Jana-Marie/OtterStepMacro/README.md

# OtterStepMacro

### Issues

 - [ ] Tab spacing needs to be 5.08mm/2" instead of 5mm
 - [ ] Move the Terminal connectors further to the board edge, maybe 0.2mm
 - [x] The two 100nF 0402 caps should be 0603
 - [x] Pullup on TRIG# OtterStepMacro
