Jana-Marie/OtterStepMacro/MacroStep.kicad_pcb

## KiCad design MacroStep.kicad_pcb (2025-08-17)

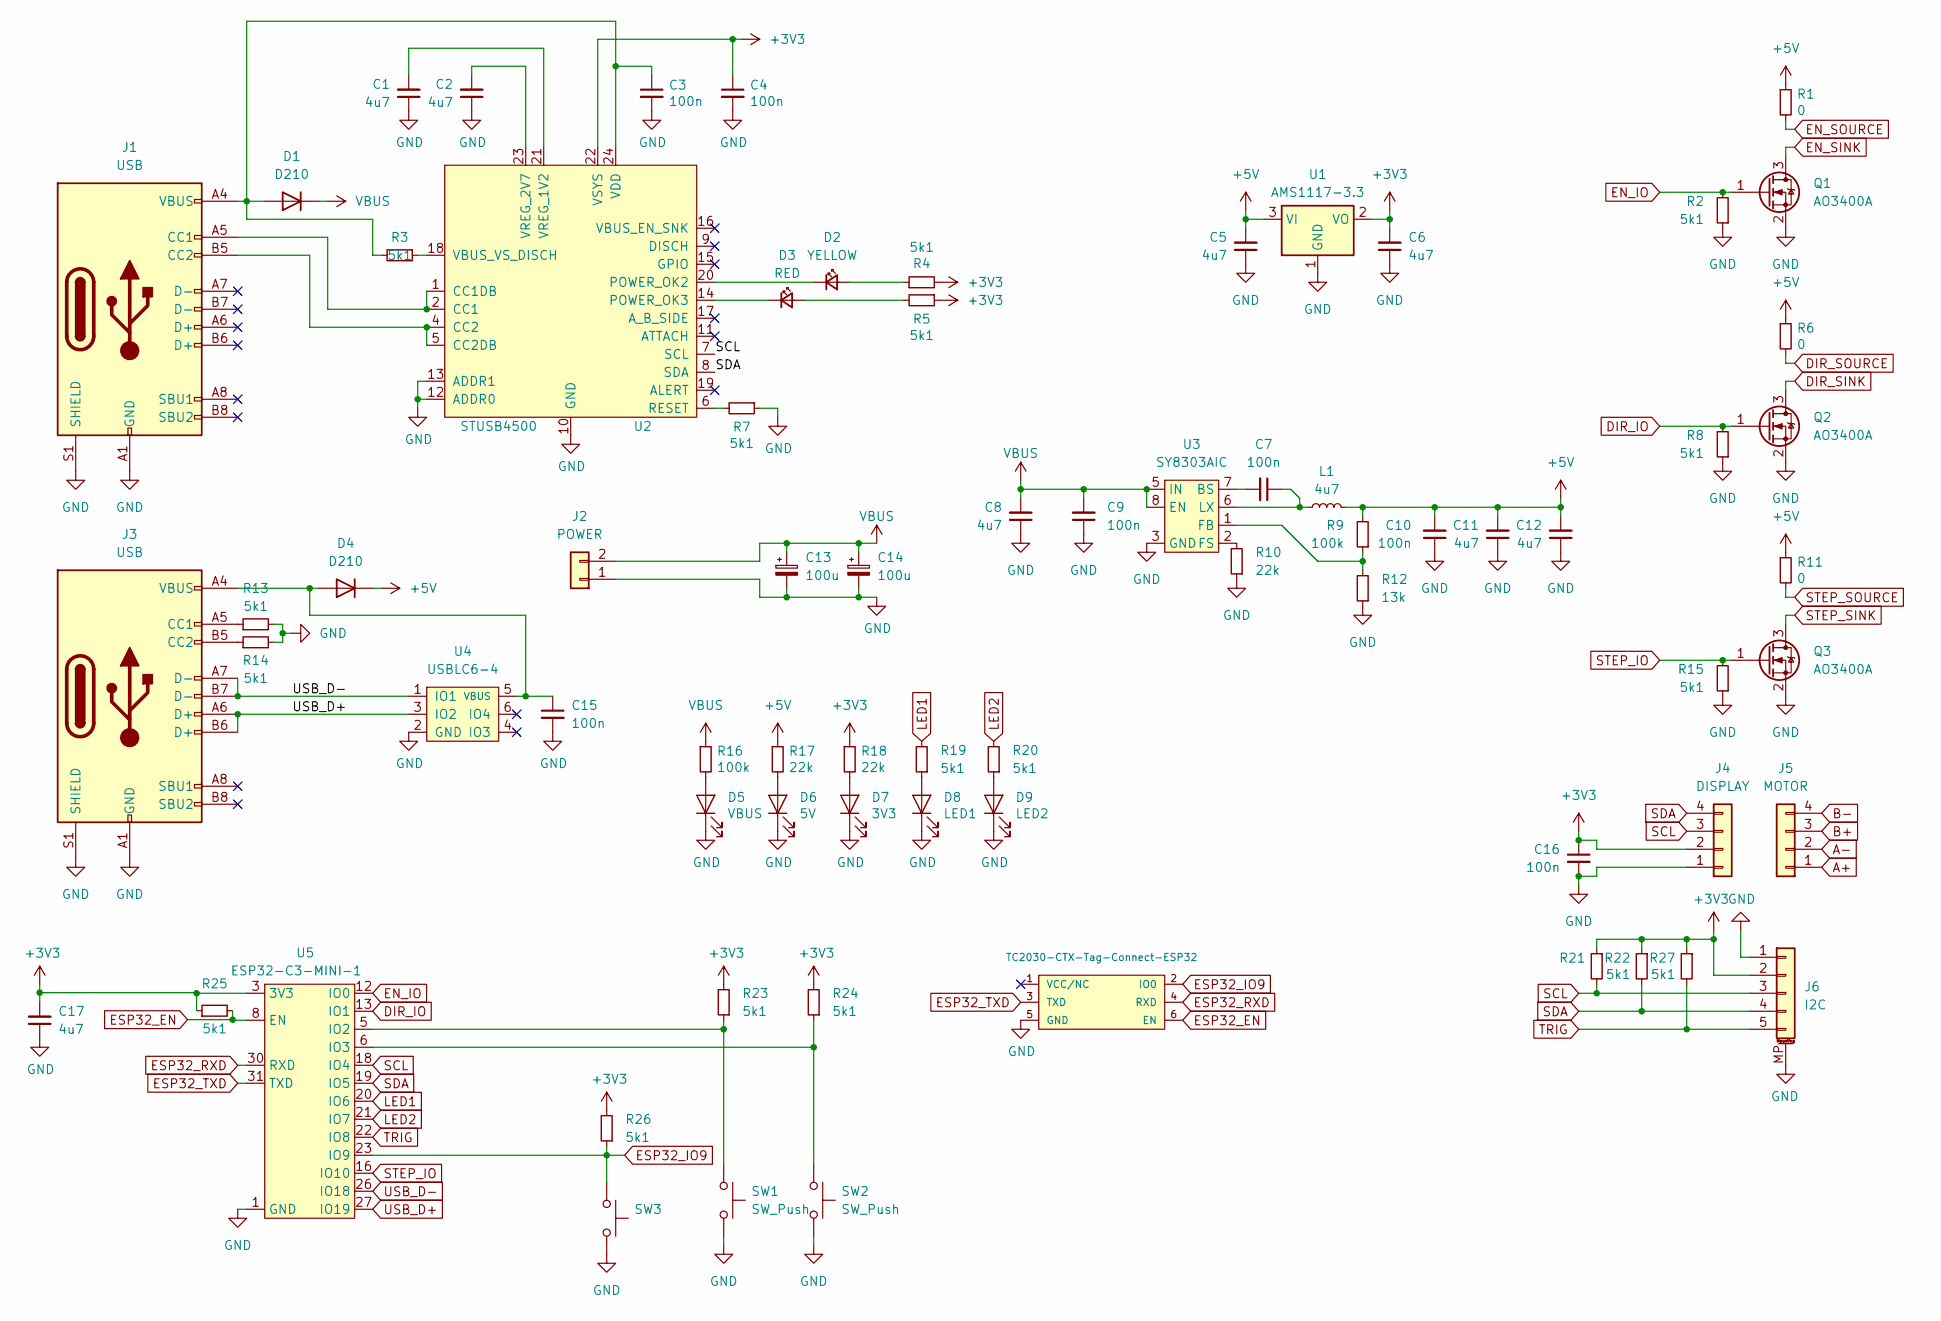
[picture p1: schematic MacroStep.kicad_sch]

Parts:
C1, C2, C5, C6, C8, C11, C12, C17: 4u7; C_0805
C3, C4, C7, C9, C10, C15, C16: 100n; C_0603
C13, C14: 100u; CP_Radial_D10.0mm_P5.00mm
D1, D4: D210; D_SMA
D2: YELLOW; LED_0603_1608Metric
D3: RED; LED_0603_1608Metric
D5: VBUS; LED_0603_1608Metric
D6: 5V; LED_0603_1608Metric
D7: 3V3; LED_0603_1608Metric
D8: LED1; LED_0603_1608Metric
D9: LED2; LED_0603_1608Metric
J1, J3: USB; USB-C 16Pin
J2: POWER; PhoenixContact_MC_1,5_2-G-3.5_1x02_P3.50mm_Horizontal
J4: DISPLAY; PinSocket_1x04_P2.54mm_Vertical_center
J5: MOTOR; PhoenixContact_MC_1,5_4-G-3.5_1x04_P3.50mm_Horizontal
J6: I2C; Molex_PicoBlade_53261-0571_1x05-1MP_P1.25mm_Horizontal
L1: 4u7; L_Taiyo-Yuden_MD-4040
P1: TC2030-CTX-Tag-Connect-ESP32; TC2030
Q1, Q2, Q3: AO3400A; SOT-23
R1, R6, R11: 0; R_0603
R2, R3, R4, R5, R7, R8, R13, R14, R15, R19, R20, R21, R22, R23, R24, R25, R26, R27: 5k1; R_0402
R9, R16: 100k; R_0402
R10, R17, R18: 22k; R_0402
R12: 13k; R_0402
SW1, SW2, SW3: SW_Push; SW_SPST_EVQP7C
U1: AMS1117-3.3; SOT-223-3_TabPin2
U2: STUSB4500; QFN-24-1EP_4x4mm_P0.5mm_EP2.7x2.7mm
U3: SY8303AIC; TSOT-23-8
U4: USBLC6-4; SOT-23-6
U5: ESP32-C3-MINI-1

Connections:
+3V3: C4.1, C6.2, C16.1, C17.2, J4.2, J6.2, R4.2, R5.1, R18.1, R21.1, R22.1, R23.2, R24.2, R25.1, R26.2, R27.1, U1.2 (VO), U2.22 (VSYS), U5.3 (3V3)
+5V: C5.2, C10.2, C11.2, C12.2, D4.1 (K), L1.2, R1.1, R6.1, R9.2, R11.1, R17.1, U1.3 (VI)
A+: J5.1
A-: J5.2
B+: J5.3
B-: J5.4
DIR_IO: Q2.1 (G), R8.2, U5.13 (IO1)
DIR_SINK: Q2.3 (D)
DIR_SOURCE: R6.2
EN_IO: Q1.1 (G), R2.2, U5.12 (IO0)
EN_SINK: Q1.3 (D)
EN_SOURCE: R1.2
ESP32_EN: P1.6 (EN), R25.2, U5.8 (EN)
ESP32_IO9: P1.2 (IO0), R26.1, SW3.1, U5.23 (IO9)
ESP32_RXD: P1.4 (RXD), U5.30 (RXD)
ESP32_TXD: P1.3 (TXD), U5.31 (TXD)
GND: C1.1, C2.1, C3.2, C4.2, C5.1, C6.1, C8.1, C9.1, C10.1, C11.1, C12.1, C13.2, C14.2, C15.2, C16.2, C17.1, D5.1 (K), D6.1 (K), D7.1 (K), D8.1 (K), D9.1 (K), J1.A1 (GND), J1.A12 (GND), J1.B1 (GND), J1.B12 (GND), J1.S1 (SHIELD), J2.1, J3.A1 (GND), J3.A12 (GND), J3.B1 (GND), J3.B12 (GND), J3.S1 (SHIELD), J4.1, J6.1, J6.MP (MountPin), P1.5 (GND), Q1.2 (S), Q2.2 (S), Q3.2 (S), R2.1, R7.1, R8.1, R10.1, R12.1, R13.2, R14.2, R15.1, SW1.2, SW2.2, SW3.2, U1.1 (GND), U2.10 (GND), U2.12 (ADDR0), U2.13 (ADDR1), U2.25 (GND), U3.3 (GND), U3.4 (GND), U4.2 (GND), U5.1 (GND), U5.2 (GND), U5.11 (GND), U5.14 (GND), U5.36 (GND), U5.37 (GND), U5.38 (GND), U5.39 (GND), U5.40 (GND), U5.41 (GND), U5.42 (GND), U5.43 (GND), U5.44 (GND), U5.45 (GND), U5.46 (GND), U5.47 (GND), U5.48 (GND), U5.49 (GND), U5.50 (GND), U5.51 (GND), U5.52 (GND), U5.53 (GND)
LED1: R19.2, U5.20 (IO6)
LED2: R20.2, U5.21 (IO7)
unnamed: C3.1, D1.2 (A), J1.A4 (VBUS), J1.A9 (VBUS), J1.B4 (VBUS), J1.B9 (VBUS), R3.2, U2.24 (VDD)
unnamed: D2.2 (A), R4.1
unnamed: D2.1 (K), U2.20 (POWER_OK2)
unnamed: D3.2 (A), R5.2
unnamed: D3.1 (K), U2.14 (POWER_OK3)
unnamed: C15.1, D4.2 (A), J3.A4 (VBUS), J3.A9 (VBUS), J3.B4 (VBUS), J3.B9 (VBUS), U4.5 (VBUS)
unnamed: D5.2 (A), R16.2
unnamed: D6.2 (A), R17.2
unnamed: D7.2 (A), R18.2
unnamed: D8.2 (A), R19.1
unnamed: D9.2 (A), R20.1
unnamed: J1.A5 (CC1), U2.1 (CC1DB), U2.2 (CC1)
unnamed: J1.B5 (CC2), U2.4 (CC2), U2.5 (CC2DB)
unnamed: J3.A5 (CC1), R13.1
unnamed: J3.B5 (CC2), R14.1
unnamed: R7.2, U2.6 (RESET)
unnamed: R3.1, U2.18 (VBUS_VS_DISCH)
unnamed: C1.2, U2.21 (VREG_1V2)
unnamed: C2.2, U2.23 (VREG_2V7)
unnamed: C7.2, U3.7 (BS)
unnamed: R9.1, R12.2, U3.1 (FB)
unnamed: R10.2, U3.2 (FS)
unnamed: C7.1, L1.1, U3.6 (LX)
unnamed: R23.1, SW1.1, U5.5 (IO2)
unnamed: R24.1, SW2.1, U5.6 (IO3)
SCL: J4.3, J6.3, R21.2, U2.7 (SCL), U5.18 (IO4)
SDA: J4.4, J6.4, R22.2, U2.8 (SDA), U5.19 (IO5)
STEP_IO: Q3.1 (G), R15.2, U5.16 (IO10)
STEP_SINK: Q3.3 (D)
STEP_SOURCE: R11.2
TRIG: J6.5, R27.2, U5.22 (IO8)
USB_D+: J3.A6 (D+), J3.B6 (D+), U4.3 (IO2), U5.27 (IO19)
USB_D-: J3.A7 (D-), J3.B7 (D-), U4.1 (IO1), U5.26 (IO18)
VBUS: C8.2, C9.2, C13.1, C14.1, D1.1 (K), J2.2, R16.1, U3.5 (IN), U3.8 (EN)

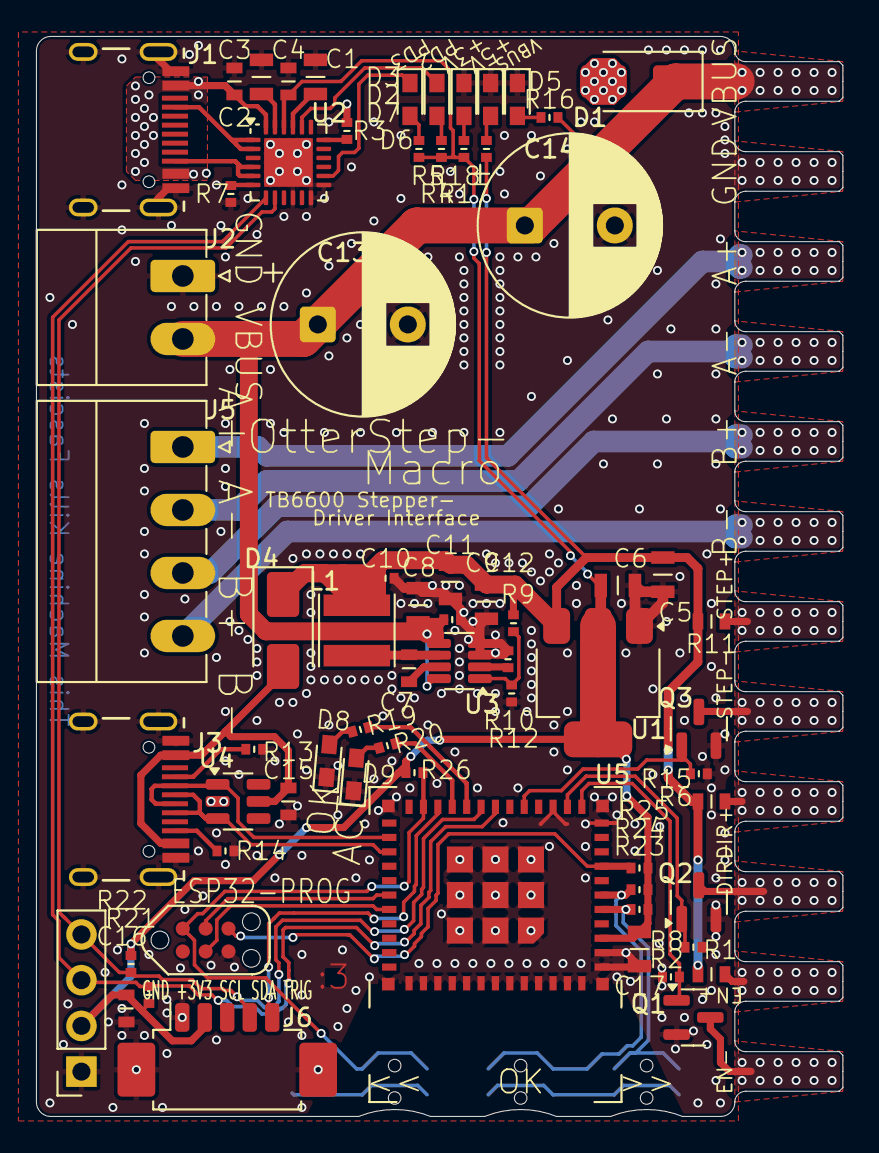
[picture p2: board MacroStep.kicad_pcb from above]

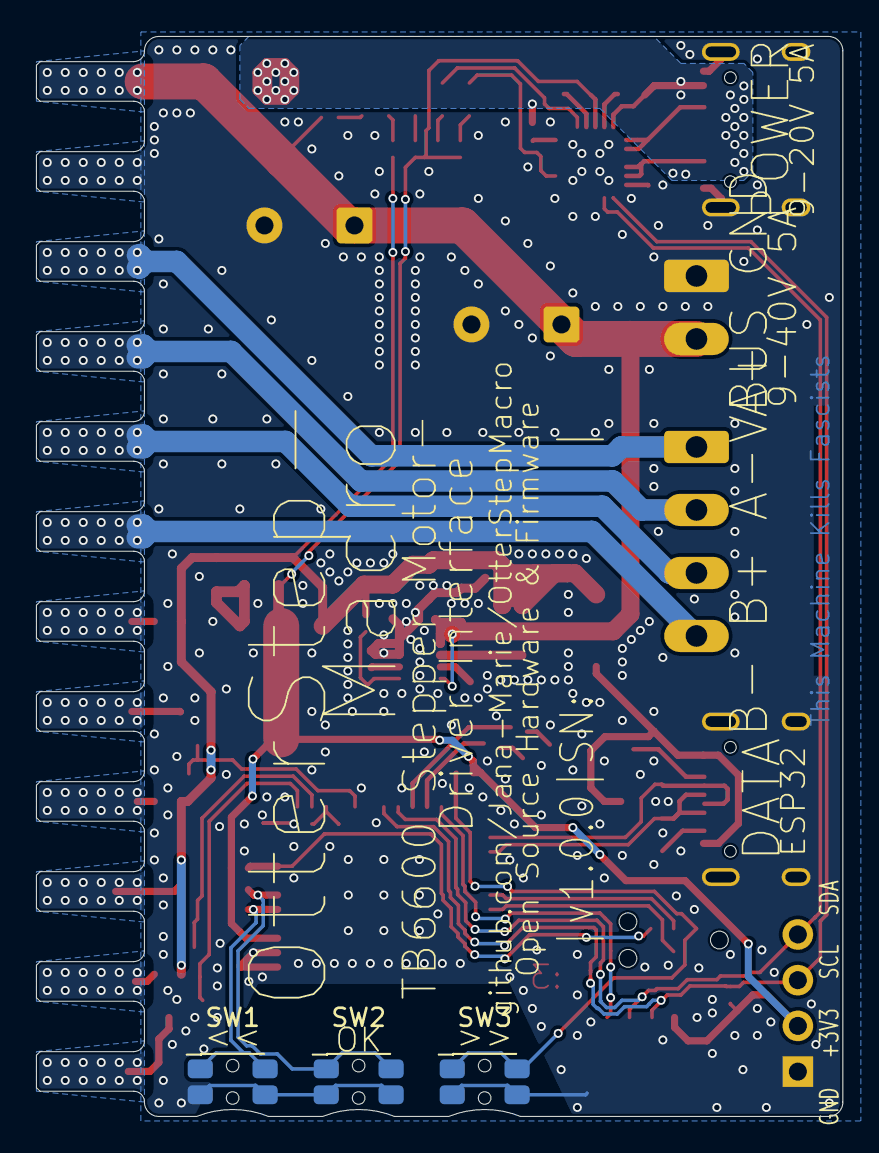
[picture p3: board MacroStep.kicad_pcb from below]

Board: 2 copper layers, 44.8 x 60.0 mm, 71 parts (3 on the bottom side), 43 nets.
