Jana-Marie/OtterStepMacro/(commit log)

2025-08-16 added kicad files
    [MacroStep.kicad_pcb, MacroStep.kicad_sch]
2025-08-16 added bom
2025-08-17 updated kicad files
    [MacroStep.kicad_pcb]
2025-08-29 added camera trigger & cleanup
